Saturday-365/25-NUEDC-C-Lower/README.md

# 25-NUEDC
## 25年电赛C题“单目视觉测距系统” 下位机

### 主要任务

1. 显示上位机摄像机回传数据
2. 读取ADC采样电流参数并显示
3. 配合串口屏，进行相关按键，参数输入操作
