Saturday-365/25-NUEDC-C-Lower/3-Document/省测/17FC5933A36BD75C654EDEC633615CD8.png

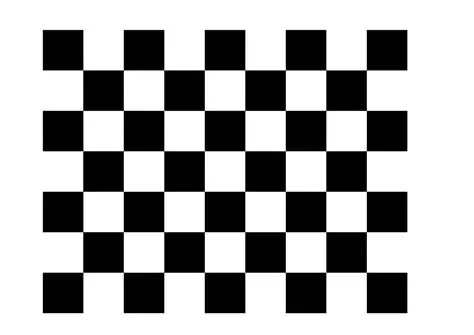
3-Document/省测/17FC5933A36BD75C654EDEC633615CD8.png
