Saturday-365/25-NUEDC-C-Lower/2-HardWare/PCB_PCB1_2025-07-30.pdf

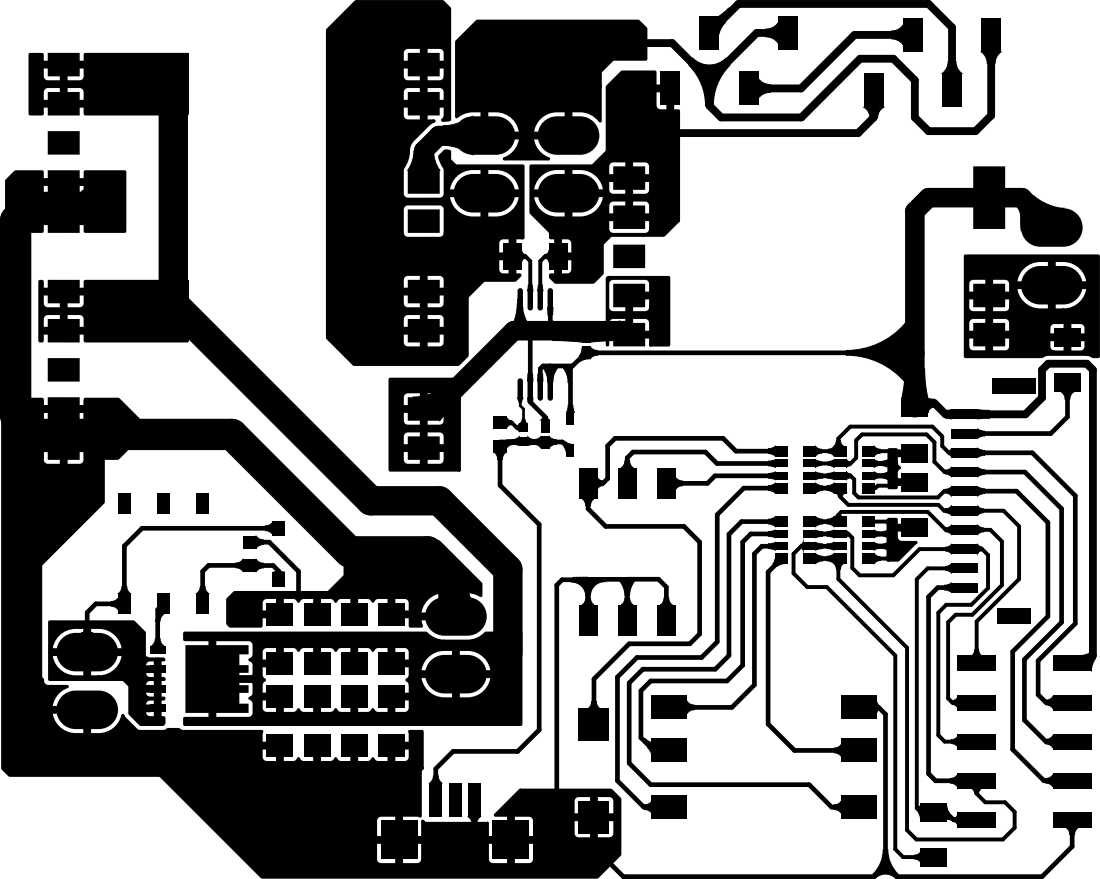
[picture p9: page 1]
