Saturday-365/25-NUEDC-C-Lower/2-HardWare/PCB_PCB3_2025-07-30.pdf

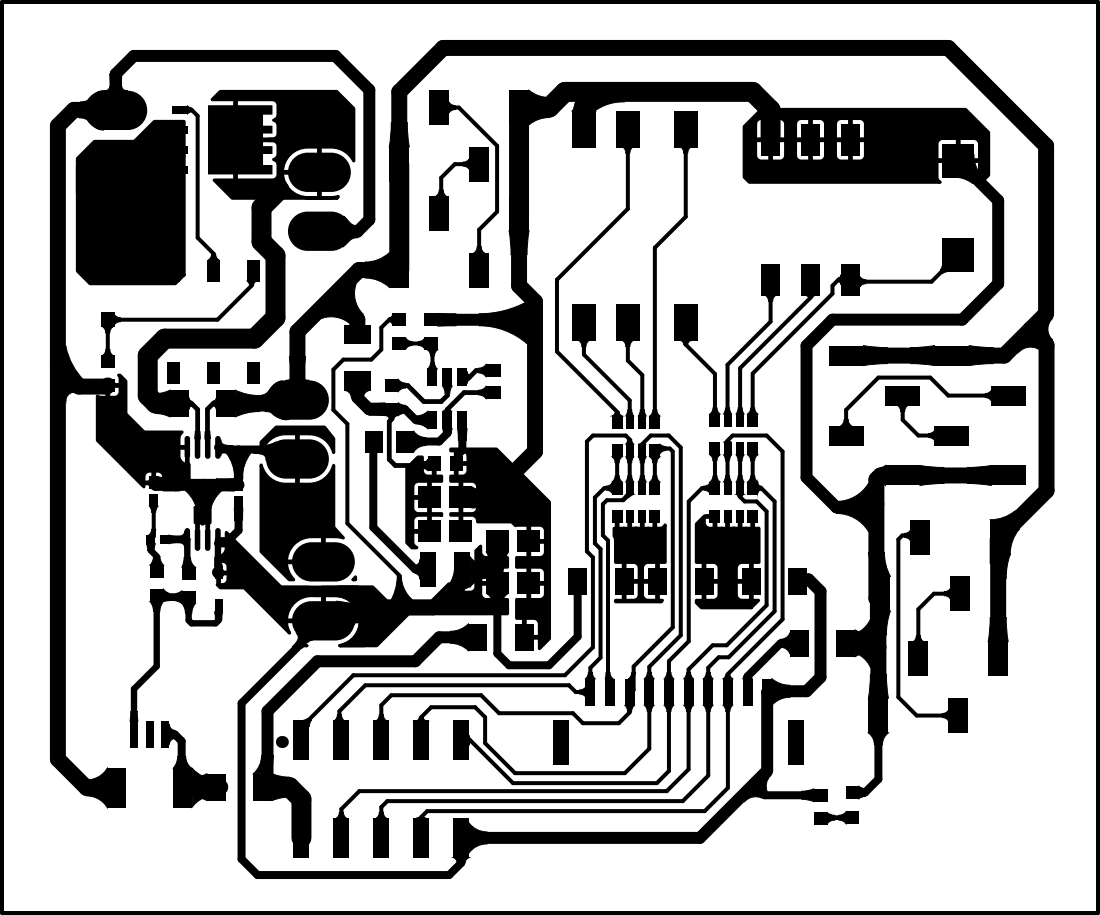
[picture p10: page 1]
