Saturday-365/25-NUEDC-C-Lower/2-HardWare/主控板PCB_PCB4_2025-07-31.pdf

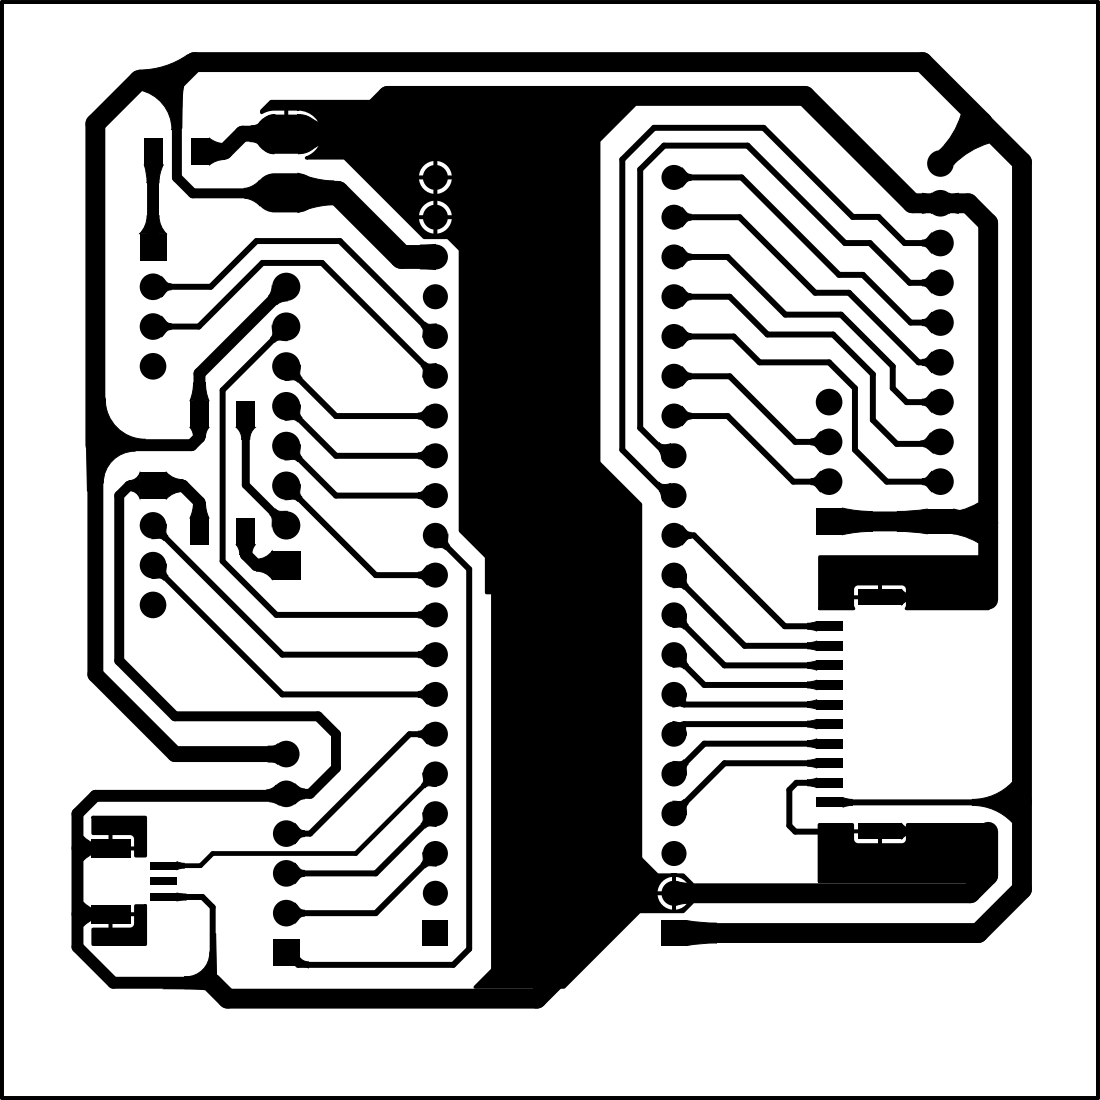
[picture p11: page 1]
