Saturday-365/25-NUEDC-C-Lower/2-HardWare/电源检测最终PCB_PCB3_2025-08-01.pdf

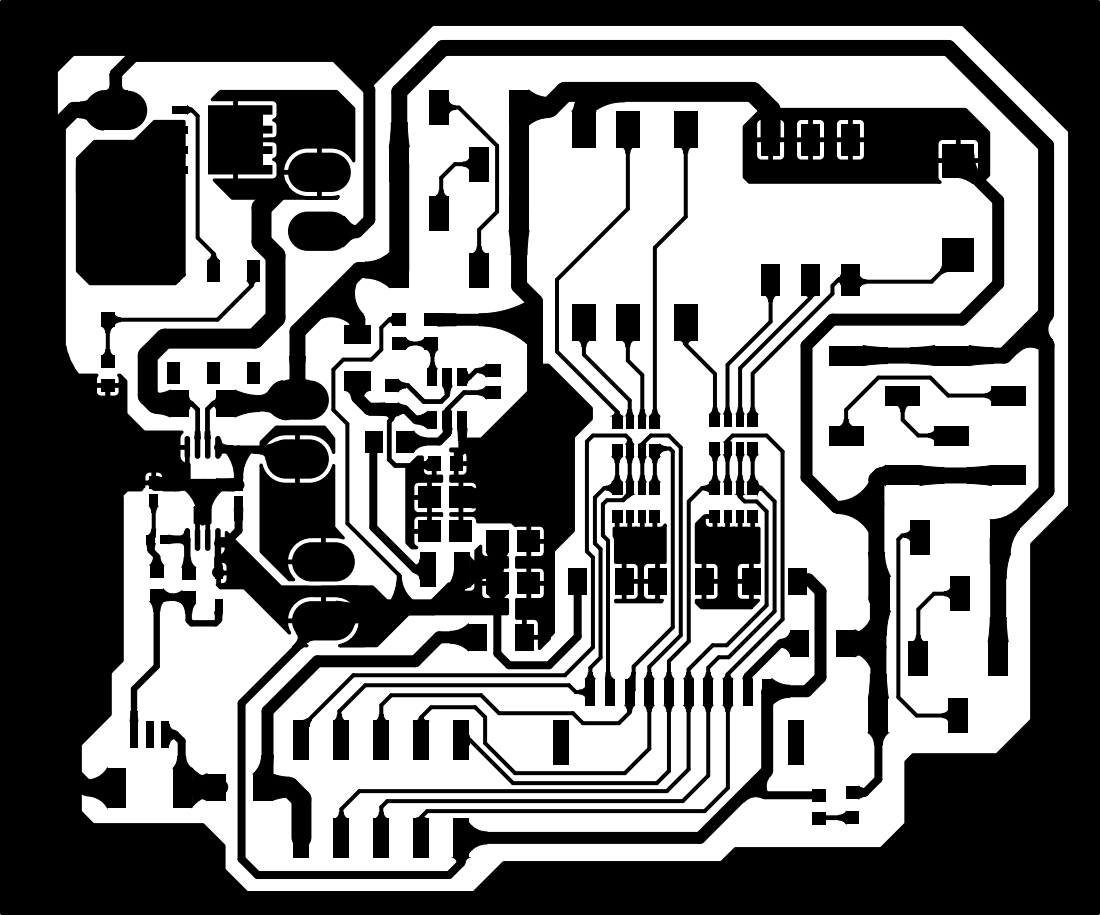
[picture p12: page 1]
