Saturday-365/25-NUEDC-C-Lower/(list of files, drawings)

Other design files:
2-HardWare/ProPrj_25电赛_2025-07-31.epro
2-HardWare/ProPrj_25电赛_2025-08-03-final.epro
3-Document/综测/17年四分频电路.ms14
3-Document/综测/17年方波产生电路.ms14
3-Document/综测/TEST1.ms14
