Saturday-365/25-NUEDC-C-Lower/1-SoftWare/STM32F103_C8T6/Core/Src/main.c

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
/* Includes ------------------------------------------------------------------*/
#include "main.h"
#include "adc.h"
#include "dma.h"
#include "spi.h"
#include "tim.h"
#include "usart.h"
#include "gpio.h"

/* USER CODE BEGIN Includes */
#include "headfile.h"
/* USER CODE END Includes */


/* USER CODE BEGIN PV */
float I_Data=0;

float I_Data_Ratio=0;
Kalman_Typedef Curreny_Kalman;
extern uint8_t window_index;
float a,b,c,d;
extern float HMI_data;
extern uint8_t RxFlag_3;
extern uint8_t modeFlag;
/* USER CODE END PV */

void SystemClock_Config(void);
/**
  * @brief  The application entry point.
  * @retval int
  */
int main(void)
{

  /* MCU Configuration--------------------------------------------------------*/

  /* Reset of all peripherals, Initializes the Flash interface and the Systick. */
  HAL_Init();

  /* Configure the system clock */
  SystemClock_Config();

  /* Initialize all configured peripherals */
  MX_GPIO_Init();
  MX_DMA_Init();
  MX_USART1_UART_Init();
  MX_USART2_UART_Init();
  MX_USART3_UART_Init();
  MX_ADC1_Init();
  MX_SPI1_Init();
  MX_TIM2_Init();
  MX_TIM3_Init();
  /* USER CODE BEGIN 2 */
    Store_Init();
    Kalman_Init(&Curreny_Kalman,0.0001,0.01);
    ADC_I_Init(&Curreny_data,5);
    HAL_TIM_Base_Start_IT(&htim2);
    HAL_TIM_Base_Start_IT(&htim3);
    HMI_Uart_DMA_RX_Init();

  /* USER CODE END 2 */

  /* Infinite loop */
  /* USER CODE BEGIN WHILE */
  while (1)
  {       
    JustFloat_4(Curreny_data.current_value_filt,Curreny_data.avg_value,Curreny_data.sum,Curreny_data.max_value);
//    JustFloat_4(Info.aim_square_num,b,c,d);
    HMI_Send_EveryInfo();
     if(HMI_key_get_state(HMI_STAR)== HMI_KEY_PRESS)
  	{
    usart3_flage=1;
    HAL_GPIO_WritePin((GPIO_TypeDef *)LED1_GPIO_Port, (uint16_t)LED1_Pin, (GPIO_PinState)0); 
	HAL_Delay(100);
    HMI_key_clear_state(HMI_STAR);
    }
    else  if(HMI_key_get_state(HMI_STOP)== HMI_KEY_PRESS)
  	{
    usart3_flage=0;
    HAL_GPIO_WritePin((GPIO_TypeDef *)LED1_GPIO_Port, (uint16_t)LED1_Pin, (GPIO_PinState)0); 
	HAL_Delay(100);
    HMI_key_clear_state(HMI_STOP);
    }

    else if(HMI_key_get_state(HMI_UP)== HMI_KEY_PRESS)
  	{
    ADC_I_DATA(&Curreny_data,1);
    HAL_GPIO_WritePin((GPIO_TypeDef *)LED1_GPIO_Port, (uint16_t)LED1_Pin, (GPIO_PinState)0); 
	HAL_Delay(100);
    HMI_key_clear_state(HMI_UP);
    }
    else if(HMI_key_get_state(HMI_DOWN)== HMI_KEY_PRESS)
  	{
    ADC_I_DATA(&Curreny_data,2);
    HAL_GPIO_WritePin((GPIO_TypeDef *)LED1_GPIO_Port, (uint16_t)LED1_Pin, (GPIO_PinState)0); 
	HAL_Delay(100);
	HMI_key_clear_state(HMI_DOWN);
    }
    else if(HMI_key_get_state(HMI_UP2)== HMI_KEY_PRESS)
  	{
    ADC_I_DATA(&Curreny_data,3);
    HAL_GPIO_WritePin((GPIO_TypeDef *)LED1_GPIO_Port, (uint16_t)LED1_Pin, (GPIO_PinState)0); 
	HAL_Delay(100);
	HMI_key_clear_state(HMI_UP2);
    }
    else if(HMI_key_get_state(HMI_DOWN2)== HMI_KEY_PRESS)
  	{
    ADC_I_DATA(&Curreny_data,4);
    HAL_GPIO_WritePin((GPIO_TypeDef *)LED1_GPIO_Port, (uint16_t)LED1_Pin, (GPIO_PinState)0); 
	HAL_Delay(100);
	HMI_key_clear_state(HMI_DOWN2);
    }
    else if(HMI_key_get_state(HMI_SA)== HMI_KEY_PRESS)
  	{
    HAL_GPIO_WritePin((GPIO_TypeDef *)LED1_GPIO_Port, (uint16_t)LED1_Pin, (GPIO_PinState)0); 
	HAL_Delay(100);
    Store_Save();
	HMI_key_clear_state(HMI_SA);
    }
    if (RxFlag_3==1){    HAL_GPIO_WritePin((GPIO_TypeDef *)LED1_GPIO_Port, (uint16_t)LED1_Pin, (GPIO_PinState)0); 
	HAL_Delay(100);}
    if (modeFlag==1){    modeFlag=0;HAL_GPIO_WritePin((GPIO_TypeDef *)LED1_GPIO_Port, (uint16_t)LED1_Pin, (GPIO_PinState)0); 
	HAL_Delay(100);modeFlag=0;}
 
    HAL_GPIO_WritePin((GPIO_TypeDef *)LED1_GPIO_Port, (uint16_t)LED1_Pin, (GPIO_PinState)1); 
    HAL_Delay(100);
    /* USER CODE END WHILE */

    /* USER CODE BEGIN 3 */
  }
  /* USER CODE END 3 */
}

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
/* USER CODE BEGIN 4 */
int16_t t=0;
//int16_t t=0;
void HAL_TIM_PeriodElapsedCallback(TIM_HandleTypeDef *htim){
    if(htim == &htim2)  //
   {
   
   Collect_CurrentData(&Curreny_data);
   Info.current_rlt=(int)(Curreny_data.current_value_filt*1000);
   Info.current_avg=(int)(Curreny_data.current_value_filt*1000);
   Info.power_rlt=(int)(Curreny_data.current_value_filt*5000);
   Info.power_max=Curreny_data.max_value*5000;
   }
     if(htim == &htim3)  //
   {
//       t++;
//       if (t>=300) {
//           t=0;  MX_USART1_UART_Init();
//        }
        send_aim_num(Info.aim_square_num);
        if(usart3_flage==0) clear_info();
//       Info.y_distance+=1;
//        Info.x_length+=1;
//        Info.square_num+=1;
//        key_scanner ();
    }  

}

/* USER CODE END 4 */
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
