Saturday-365/25-NUEDC-C-Lower/1-SoftWare/STM32F103_C8T6/STM32F103_C8T6.ioc

Mcu.UserName=STM32F103C8Tx
PA0-WKUP.Signal=ADCx_IN0
PA10.Signal=USART1_RX
PA13.Signal=SYS_JTMS-SWDIO
PA14.Signal=SYS_JTCK-SWCLK
PA15.GPIO_Label=BTN0
PA15.Signal=GPIO_Input
PA2.Signal=USART2_TX
PA3.Signal=USART2_RX
PA4.GPIO_Label=IPS_CS
PA4.Signal=GPIO_Output
PA5.Signal=SPI1_SCK
PA6.Signal=GPIO_Output
PA7.Signal=SPI1_MOSI
PA9.Signal=USART1_TX
PB0.GPIO_Label=IPS_RES
PB0.Signal=GPIO_Output
PB1.GPIO_Label=IPS_DC
PB1.Signal=GPIO_Output
PB10.Signal=USART3_TX
PB11.Signal=USART3_RX
PB3.GPIO_Label=BTN1
PB3.Signal=GPIO_Input
PB4.GPIO_Label=BTN2
PB4.Signal=GPIO_Input
PB5.GPIO_Label=BTN3
PB5.Signal=GPIO_Input
PB6.GPIO_Label=BTN4
PB6.Signal=GPIO_Input
PB7.GPIO_Label=BTN5
PB7.Signal=GPIO_Input
PB8.GPIO_Label=BTN6
PB8.Signal=GPIO_Input
PB9.GPIO_Label=BTN7
PB9.Signal=GPIO_Input
PC13-TAMPER-RTC.GPIO_Label=LED1
PC13-TAMPER-RTC.Signal=GPIO_Output
PC14-OSC32_IN.Signal=RCC_OSC32_IN
PC15-OSC32_OUT.Signal=RCC_OSC32_OUT
PD0-OSC_IN.Signal=RCC_OSC_IN
PD1-OSC_OUT.Signal=RCC_OSC_OUT
