Saturday-365/25-NUEDC-C-Lower/1-SoftWare/STM32F103_C8T6/Core/Inc/main.h

#define LED1_Pin GPIO_PIN_13
#define LED1_GPIO_Port GPIOC
#define IPS_CS_Pin GPIO_PIN_4
#define IPS_CS_GPIO_Port GPIOA
#define IPS_RES_Pin GPIO_PIN_0
#define IPS_RES_GPIO_Port GPIOB
#define IPS_DC_Pin GPIO_PIN_1
#define IPS_DC_GPIO_Port GPIOB
#define BTN0_Pin GPIO_PIN_15
#define BTN0_GPIO_Port GPIOA
#define BTN1_Pin GPIO_PIN_3
#define BTN1_GPIO_Port GPIOB
#define BTN2_Pin GPIO_PIN_4
#define BTN2_GPIO_Port GPIOB
#define BTN3_Pin GPIO_PIN_5
#define BTN3_GPIO_Port GPIOB
#define BTN4_Pin GPIO_PIN_6
#define BTN4_GPIO_Port GPIOB
#define BTN5_Pin GPIO_PIN_7
#define BTN5_GPIO_Port GPIOB
#define BTN6_Pin GPIO_PIN_8
#define BTN6_GPIO_Port GPIOB
#define BTN7_Pin GPIO_PIN_9
#define BTN7_GPIO_Port GPIOB
