Saturday-365/25-NUEDC-C-Lower/1-SoftWare/STM32F103_C8T6/Sourse_Library/1_SA_Library/SA_ADC.c

#include "main.h"
#include "SA_ADC.h"
#include "HMI.h"
#include "SA_karman.h"
#include "adc.h"
#include "dma.h"
#include "SA_Flash.h"
Data_I_TypeDef Curreny_data;

volatile uint16_t ADC_buffer[1]={0};
#define WINDOW_SIZE 20

static float window_buffer[WINDOW_SIZE] = {0};  // 滑动窗口缓冲区
uint8_t window_index = 0;     // 当前缓冲区索引
static uint8_t sample_count = 0;     // 已采样总数（用于初始化阶段）
static float window_sum = 0.0f;      // 窗口内数据总和

void ADC_I_Init(Data_I_TypeDef *DATA,uint32_t total_count){
    HAL_ADCEx_Calibration_Start(&hadc1);//ADC自动校准
    HAL_Delay(2000);//延时200ms
    DATA->max_value=0;
    DATA->avg_value=0;
    DATA->current_value=0;
    DATA->raw_value=0;
    DATA->raw_value_filt=0;
    if (flahs_flage == 1) 
        {    
   
            DATA->Correct_parameters_k=0.849843;
            DATA->Correct_parameters_b=28.0369;
            DATA->INA240mode=40.0f;
            Store_Data[1] = float_to_uint16_mem_high(DATA->Correct_parameters_k);
            Store_Data[3] = float_to_uint16_mem_low(DATA->Correct_parameters_k);
            Store_Data[5] = float_to_uint16_mem_high(DATA->Correct_parameters_b);
            Store_Data[7] = float_to_uint16_mem_low(DATA->Correct_parameters_b);
            Store_Data[9] = float_to_uint16_mem_high(DATA->INA240mode);
            Store_Data[11] = float_to_uint16_mem_low(DATA->INA240mode);
            Store_Save();
       }
    else {   
       
        DATA->Correct_parameters_k=uint16s_to_float(Store_Data[1],Store_Data[3]);
        DATA->Correct_parameters_b=uint16s_to_float(Store_Data[5],Store_Data[7]);
        DATA->INA240mode=uint16s_to_float(Store_Data[9],Store_Data[11]);
    }
    Info.ina240=(int)DATA->INA240mode;   

    DATA->total_count=total_count;
    DATA->count=0;
    DATA->sum=0;
    DATA->current_value_filt=0;
    
    Info.parameters_k=DATA->Correct_parameters_k*10000;
    Info.parameters_b=DATA->Correct_parameters_b*1000;

}    
extern Kalman_Typedef Curreny_Kalman;

void ADC_I_DATA(Data_I_TypeDef *DATA,uint8_t flage){
    if (flage==1) DATA->Correct_parameters_k+=0.01;
    else if (flage==2) DATA->Correct_parameters_k-=0.01;
    else if (flage==3) DATA->Correct_parameters_b+=1.0;
    else if (flage==4) DATA->Correct_parameters_b-=1.0;

//    float_to_uint16(DATA->Correct_parameters_k,&Store_Data[0],&Store_Data[1]);  //浮点数存入uint16
//    float_to_uint16(DATA->Correct_parameters_b,&Store_Data[2],&Store_Data[3]);  //浮点数存入uint16

    Store_Data[1] = float_to_uint16_mem_high(DATA->Correct_parameters_k);
    Store_Data[3] = float_to_uint16_mem_low(DATA->Correct_parameters_k);
    Store_Data[5] = float_to_uint16_mem_high(DATA->Correct_parameters_b);
    Store_Data[7] = float_to_uint16_mem_low(DATA->Correct_parameters_b);
    Info.parameters_k=DATA->Correct_parameters_k*10000;
    Info.parameters_b=DATA->Correct_parameters_b*1000;
    
}    
float Get_I_Data(void){
   HAL_ADC_Start_DMA(&hadc1,(uint32_t*)ADC_buffer,1);
    return ADC_buffer[0];
}


void INA240MODE_change(Data_I_TypeDef *data){

    if(data->INA240mode==40.0) data->INA240mode=20.0;
    else  data->INA240mode=40.0;
    Info.ina240=(int) data->INA240mode; 
    Store_Data[9] = float_to_uint16_mem_high(data->INA240mode);
    Store_Data[11] = float_to_uint16_mem_low(data->INA240mode);  
    Store_Save();
}
uint8_t Collect_CurrentData(Data_I_TypeDef *data) {
    
    // 获取当前电流值（调用现有函数）
    data->raw_value=Get_I_Data();
    data->raw_value_filt = KalmanFilter(&Curreny_Kalman,data->raw_value);
    
    data->current_value=data->raw_value_filt/(4096/3.3818* data->INA240mode *0.01); 
    
    data->current_value_filt = data->Correct_parameters_k*data->current_value - (data->Correct_parameters_b/1000);

    if (data->current_value_filt<=0) data->current_value_filt=0;
    // 更新最大值
    if (sample_count == 0 ||data->current_value_filt > data->max_value) {
        data->max_value = data->current_value_filt;
    }
    
    //// 获取滑动窗口平均值
    if (sample_count < WINDOW_SIZE) {
        // 初始化阶段：直接累加
        window_sum += data->current_value_filt;
        window_buffer[window_index++] = data->current_value_filt;
    } else {
        // 窗口已满：先减去即将移除的值，再加新值
        window_sum -= window_buffer[window_index-1];
        window_sum += data->current_value_filt;
        window_buffer[window_index-1] = data->current_value_filt;
        window_index = (window_index + 1) % WINDOW_SIZE;  // 循环索引
    }
    
    if (sample_count<WINDOW_SIZE)
    {
        sample_count++;  // 总采样数递增
    }
    else sample_count=WINDOW_SIZE;
    
    // 初始化阶段（未填满窗口）用实际采样数计算
    uint8_t actual_count = (sample_count <= WINDOW_SIZE) ? sample_count : WINDOW_SIZE;
    data->avg_value = window_sum / (actual_count+1);

    return 1; // 采集成功
}
