Saturday-365/25-NUEDC-C-Lower/1-SoftWare/STM32F103_C8T6/Sourse_Library/1_SA_Library/headfile.h

#ifndef __HEADFILE_H_
#define __HEADFILE_H_

//#include "dma.h"

#include "main.h"
//HAL库头文件
#include "stdio.h"
#include "string.h"
//C语言头文件
#include "common.h"
#include "SA_karman.h"
#include "SA_uppercpu.h"
#include "SA_Usart.h"
#include "SA_Flash.h"
#include "SA_ADC.h"
#include "SA_Key.h"
#include "lcd.h"
#include "GUI.h"
#include "HMI.h"
#endif
