Saturday-365/25-NUEDC-C-Lower/(commit log)

2025-08-01 File fixed
    [ProPrj_25电赛_2025-07-31.epro, stm32计算器.xlsx, 智能车计算器.xlsx, 电赛.xlsx]
2025-08-01 SA_Flash OK
    [电赛.xlsx]
2025-08-02 final？
2025-08-03 final！
2025-08-06 modifie readme
    [17年方波产生电路.ms14, 25年电赛综测准备.xlsx, TEST1.ms14]
