Saturday-365/25-NUEDC-C-Lower/(notices)

Notices in the files:
1-SoftWare/STM32F103_C8T6/Core/Inc/main.h:
Copyright (c) 2025 STMicroelectronics.
All rights reserved.
This software is licensed under terms that can be found in the LICENSE file
